morganwang7777-ux/5V-DC-DC-Buck-Converter/Screenshots/2DBuck_Bottom.png

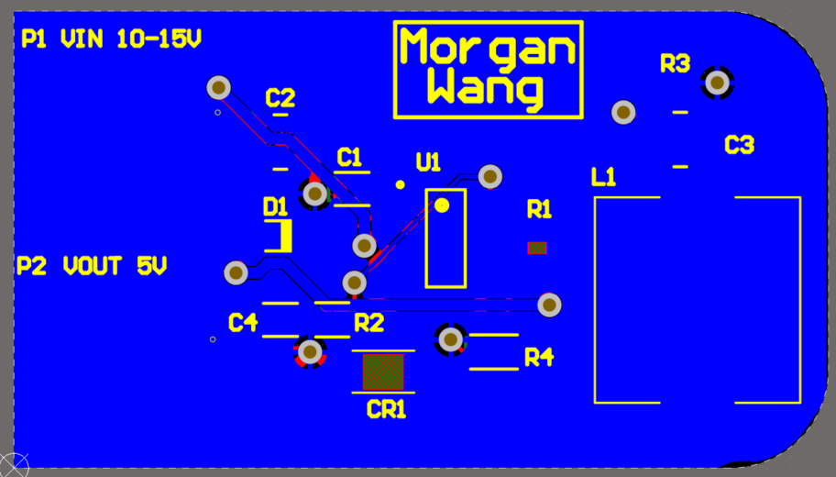
Screenshots/2DBuck_Bottom.png
