morganwang7777-ux/5V-DC-DC-Buck-Converter/Screenshots/2DBuck_Top.png

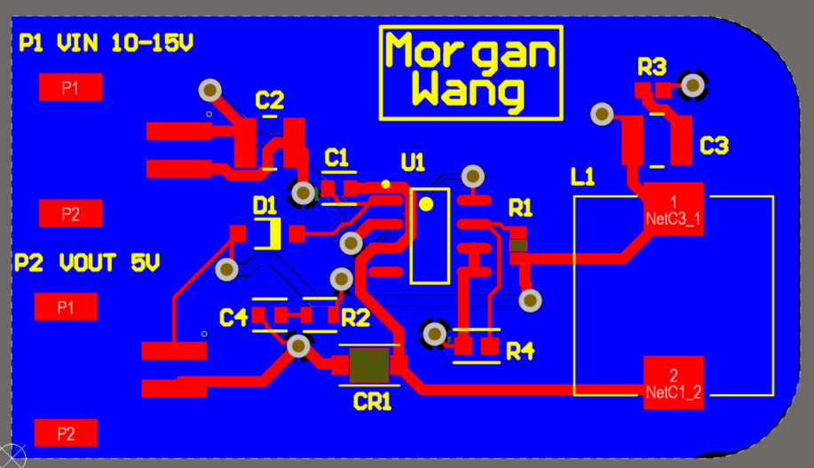
Screenshots/2DBuck_Top.png
