morganwang7777-ux/5V-DC-DC-Buck-Converter/Screenshots/Altium_Schematic.png

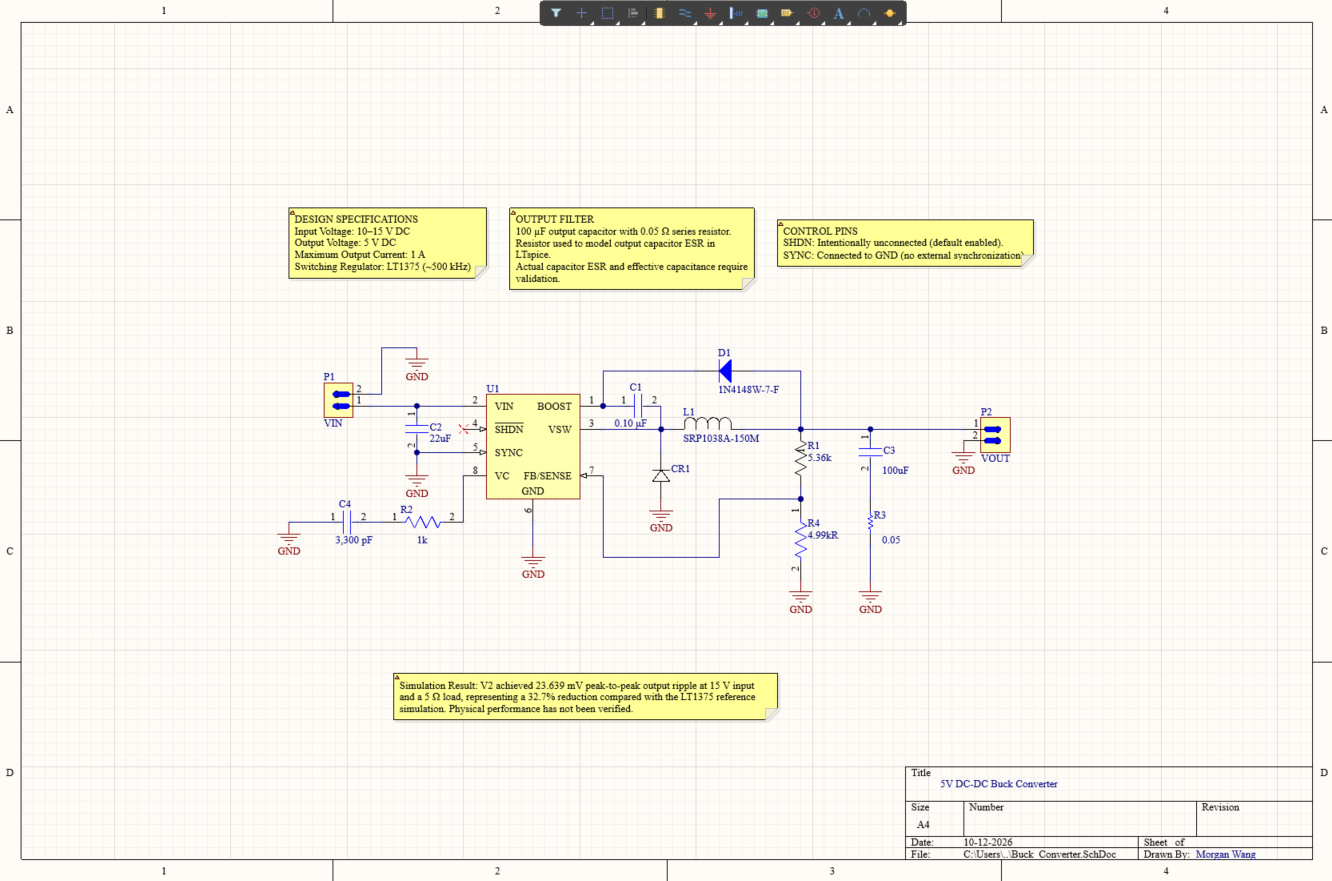
Screenshots/Altium_Schematic.png
