morganwang7777-ux/5V-DC-DC-Buck-Converter/Screenshots/Buck_Bottom.png

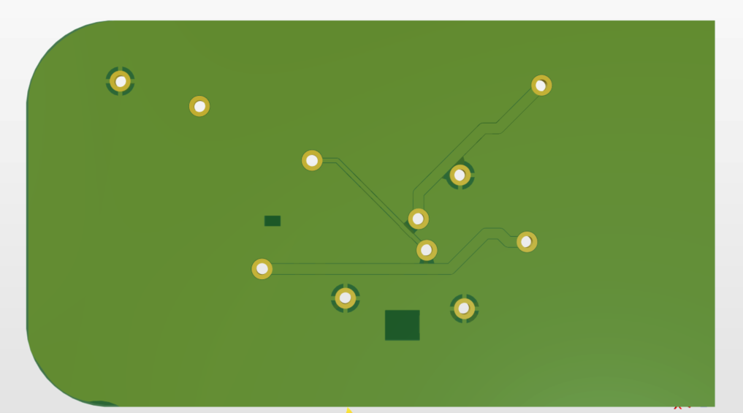
Screenshots/Buck_Bottom.png
