morganwang7777-ux/5V-DC-DC-Buck-Converter/Screenshots/Buck_Topview.png

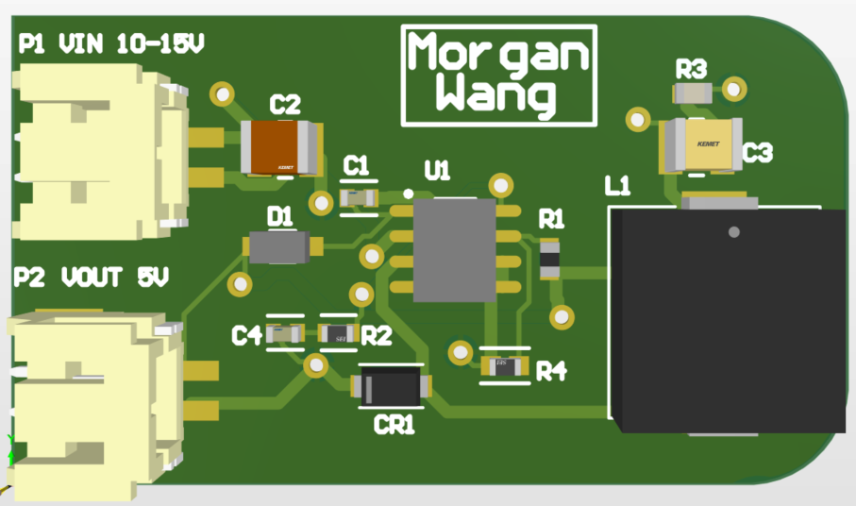
Screenshots/Buck_Topview.png
