morganwang7777-ux/5V-DC-DC-Buck-Converter/Screenshots/datasheetripple.png

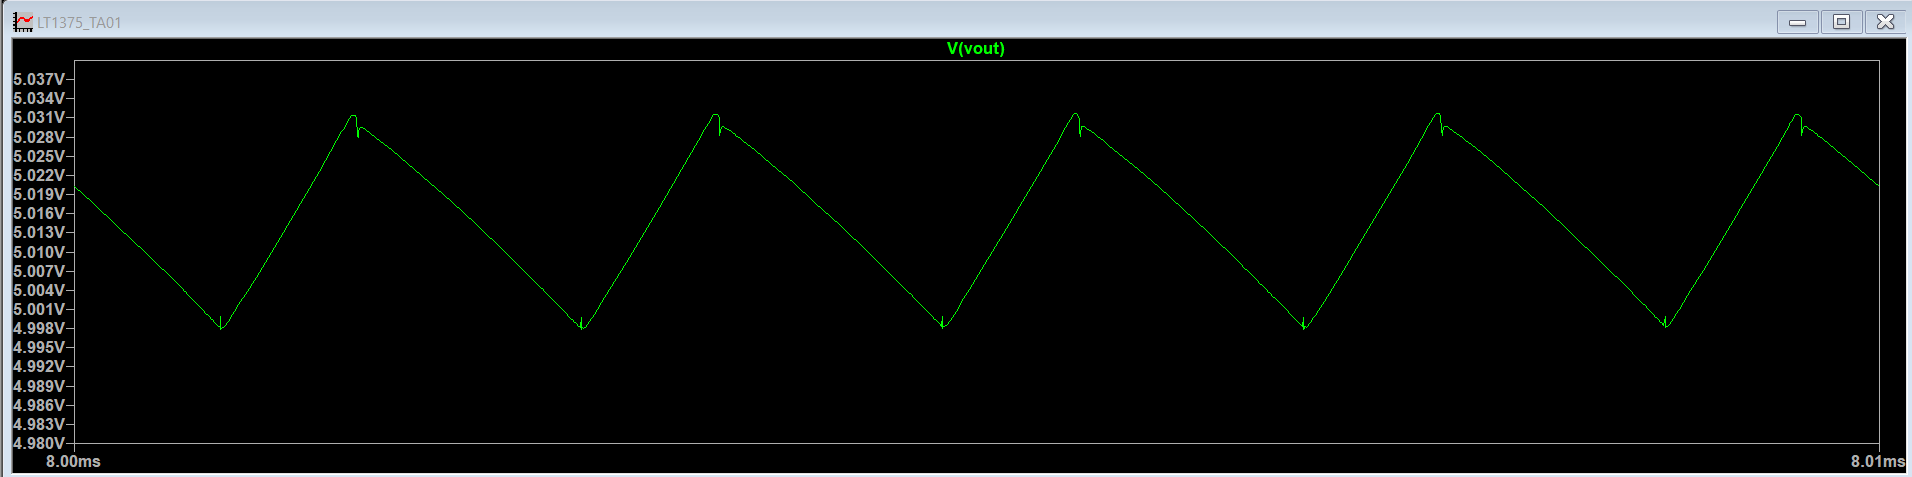
Screenshots/datasheetripple.png
