morganwang7777-ux/5V-DC-DC-Buck-Converter/Screenshots/datasheetschematic.png

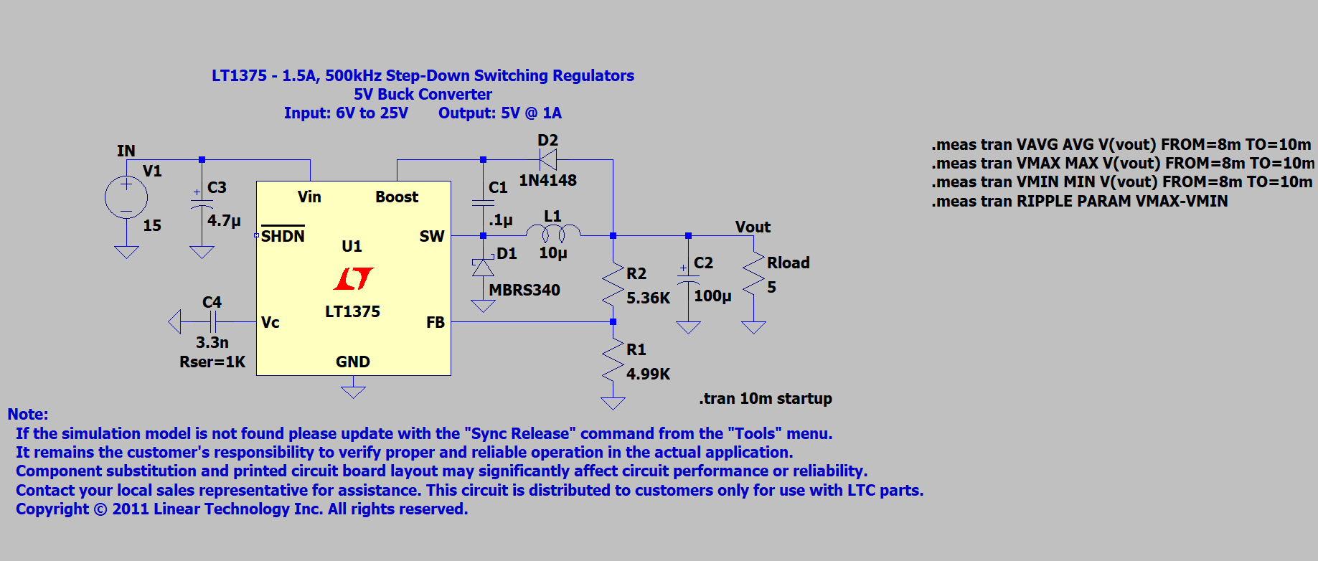
Screenshots/datasheetschematic.png
