morganwang7777-ux/5V-DC-DC-Buck-Converter/Screenshots/datasheetvoltagegraph.png

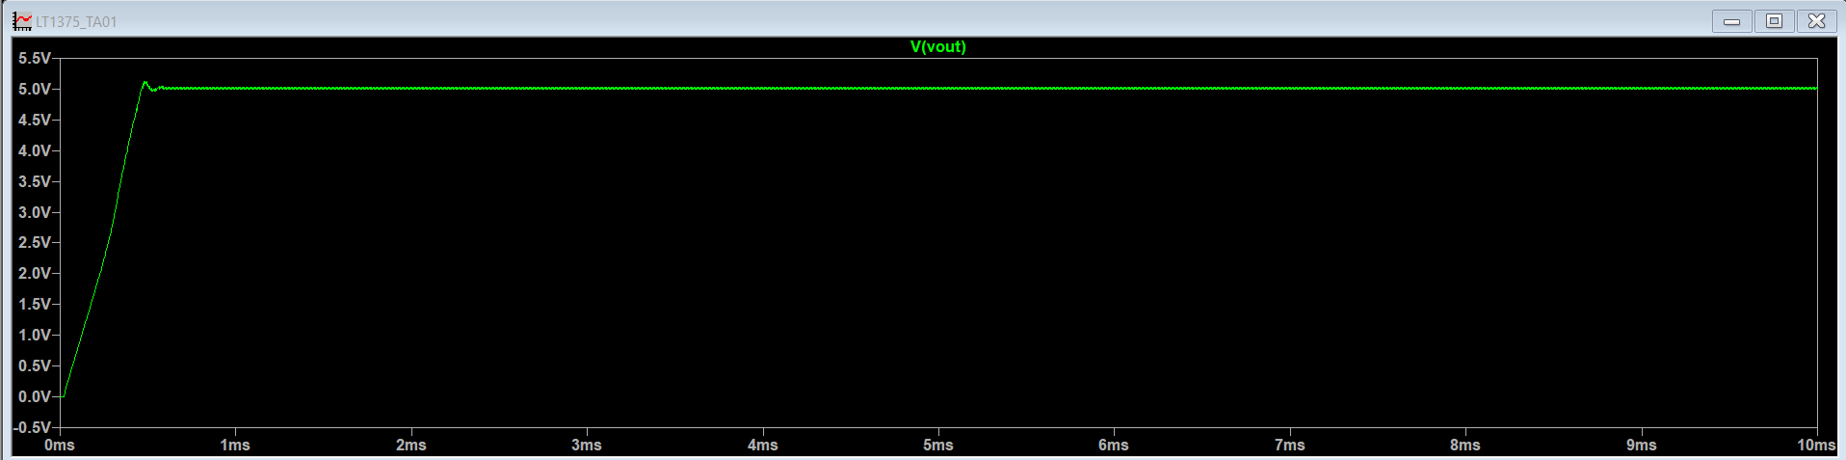
Screenshots/datasheetvoltagegraph.png
