morganwang7777-ux/5V-DC-DC-Buck-Converter/Screenshots/v1ripple.png

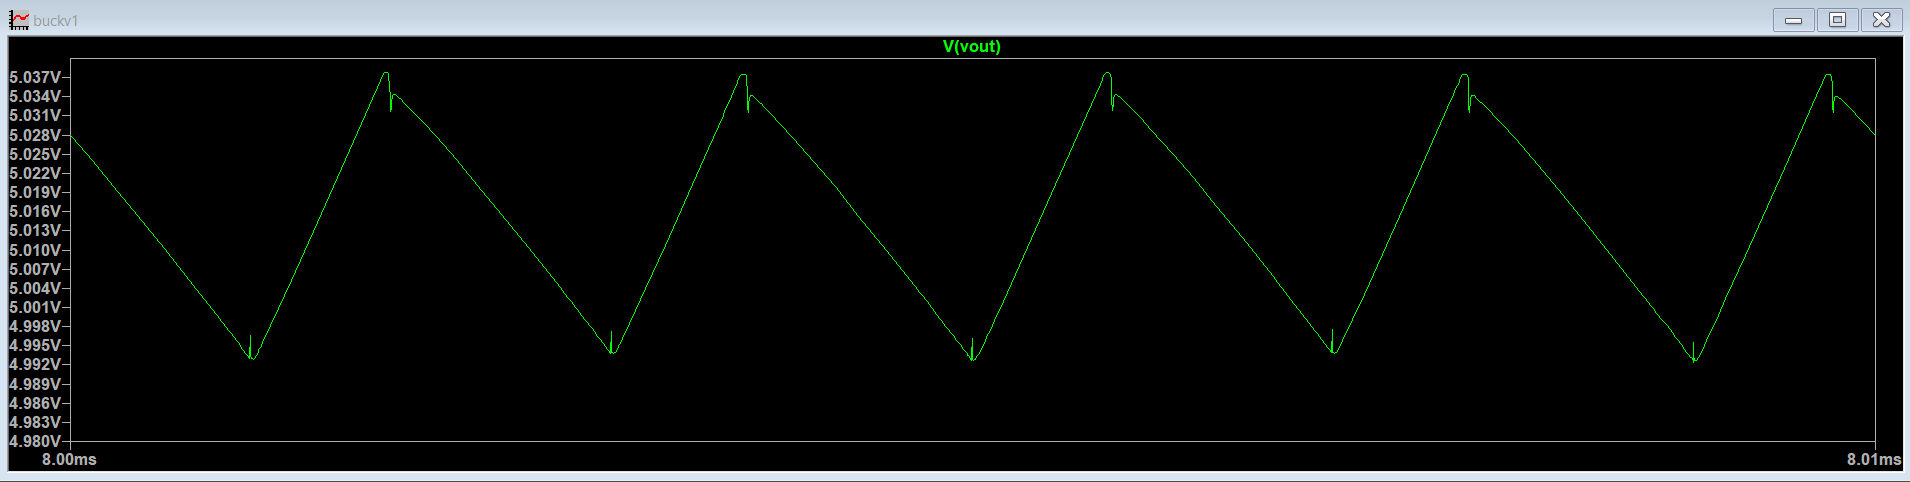
Screenshots/v1ripple.png
