morganwang7777-ux/5V-DC-DC-Buck-Converter/Screenshots/v1schematic.png

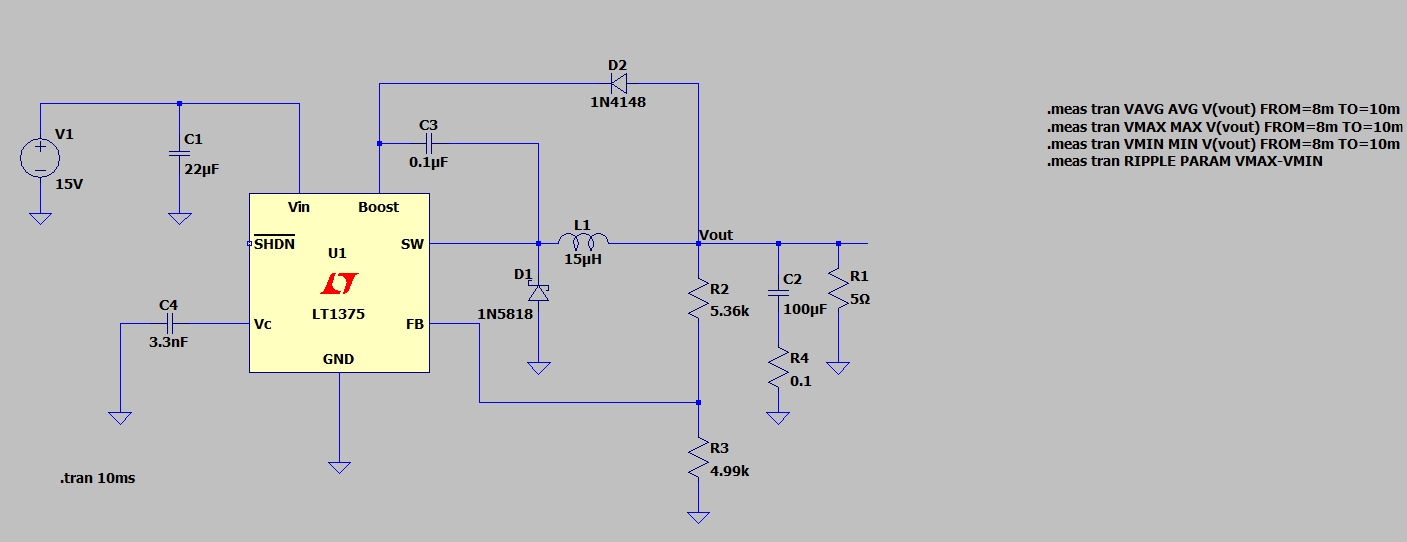
Screenshots/v1schematic.png
