morganwang7777-ux/5V-DC-DC-Buck-Converter/Screenshots/v2ripple.png

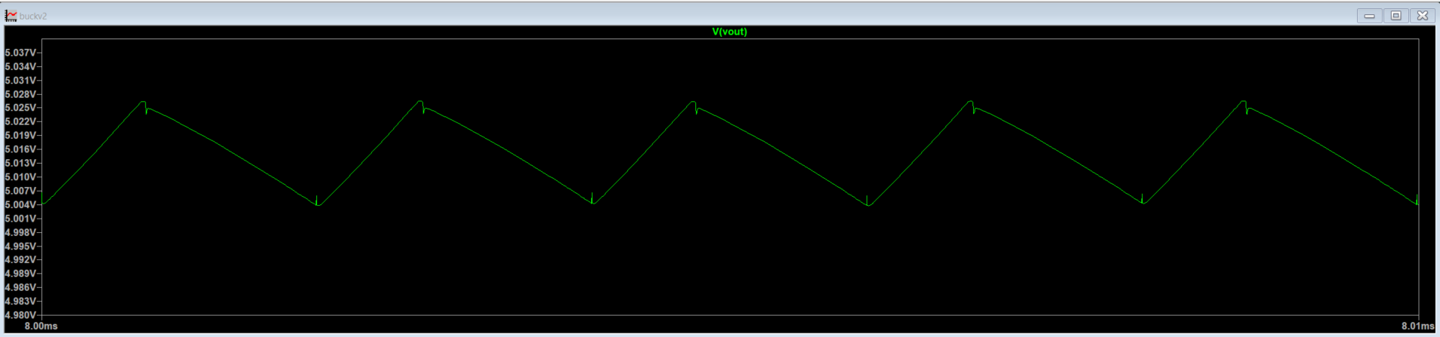
Screenshots/v2ripple.png
