morganwang7777-ux/5V-DC-DC-Buck-Converter/Screenshots/v2schematic.png

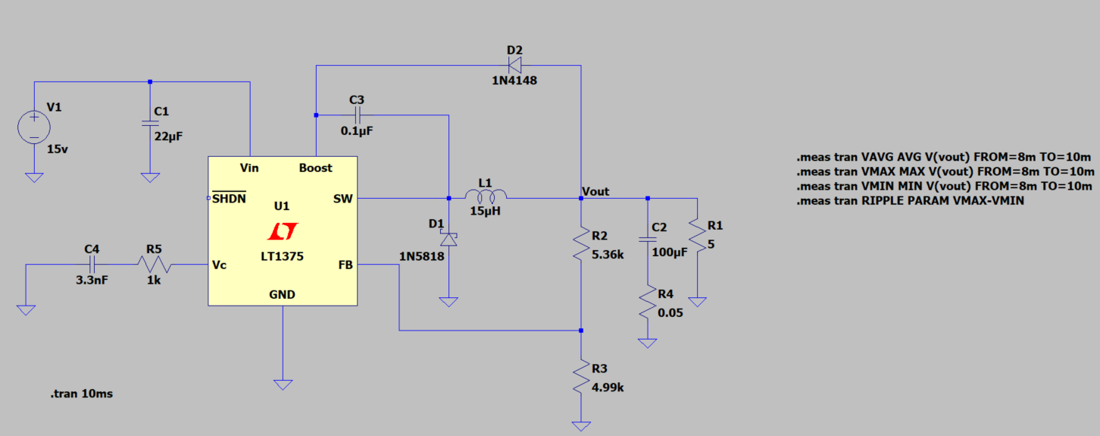
Screenshots/v2schematic.png
