morganwang7777-ux/5V-DC-DC-Buck-Converter/LTSpice/buckv2.asc

C1: cap; 22µF
C2: cap; 100µF
C3: cap; 0.1µF
C4: cap; 3.3nF
D1: schottky; 1N5818
D2: diode; 1N4148
L1: ind; 15µH; Rser=1m
R1: res; 5
R2: res; 5.36k
R3: res; 4.99k
R4: res; 0.05
R5: res; 1k
U1: LT1375
V1: voltage; 15v
Named nets: 0, Vout
.tran 10ms
.meas tran VAVG AVG V(vout) FROM=8m TO=10m
.meas tran VMAX MAX V(vout) FROM=8m TO=10m
.meas tran VMIN MIN V(vout) FROM=8m TO=10m
.meas tran RIPPLE PARAM VMAX-VMIN
