morganwang7777-ux/5V-DC-DC-Buck-Converter/LTSpice/LT1375_TA01.asc

C1: cap; .1µ
C2: POLCAP; 100µ; Rser=0.05
C3: POLCAP; 4.7µ; Rser=0.02
C4: cap; 3.3n; Rser=1K
D1: schottky; MBRS340
D2: DIODE; 1N4148
L1: IND; 10µ; Rser=0.02 Rpar=5000
R1: RES; 4.99K
R2: res; 5.36K
Rload: res; 5
U1: LT1375
V1: VOLTAGE; 15; Rser=0.1
Named nets: 0, Vout, IN
.tran 10m startup
LT1375 - 1.5A, 500kHz Step-Down Switching Regulators
5V Buck Converter
Input: 6V to 25V       Output: 5V @ 1A
Note:
  If the simulation model is not found please update with the "Sync Release" command from the "Tools" menu.
  It remains the customer's responsibility to verify proper and reliable operation in the actual application.
  Component substitution and printed circuit board layout may significantly affect circuit performance or reliability.
  Contact your local sales representative for assistance. This circuit is distributed to customers only for use with LTC parts.
  Copyright © 2011 Linear Technology Inc. All rights reserved.
.meas tran VAVG AVG V(vout) FROM=8m TO=10m
.meas tran VMAX MAX V(vout) FROM=8m TO=10m
.meas tran VMIN MIN V(vout) FROM=8m TO=10m
.meas tran RIPPLE PARAM VMAX-VMIN
