morganwang7777-ux/5V-DC-DC-Buck-Converter/(list of files, drawings)

Other design files:
Altium/5V_Buck_Converter.PrjPcb
Altium/5V_Buck_Final.PcbDoc
Altium/Buck_Converter.SchDoc
