morganwang7777-ux/5V-DC-DC-Buck-Converter/Results/RippleComparison.png

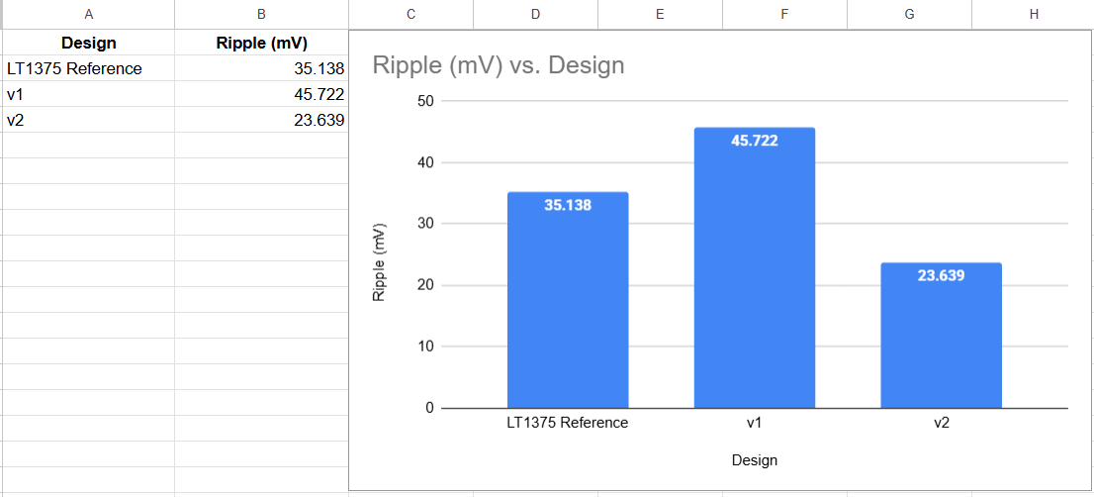
Results/RippleComparison.png
